hanskimvz/ELOP/doc/image/Create_a_beautiful_modern_and_visually_appealing-1786338362931.png

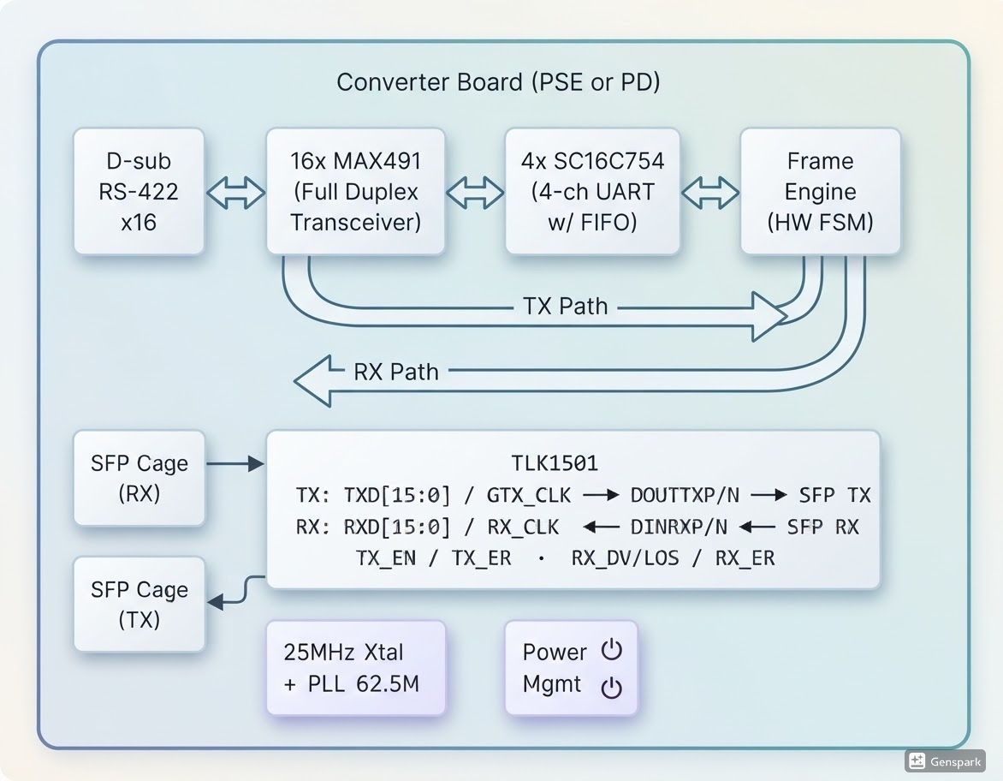
doc/image/Create_a_beautiful_modern_and_visually_appealing-1786338362931.png
