hanskimvz/ELOP/doc/RS422_-_광_컨버터_개발_제안_20260803103215.pptx

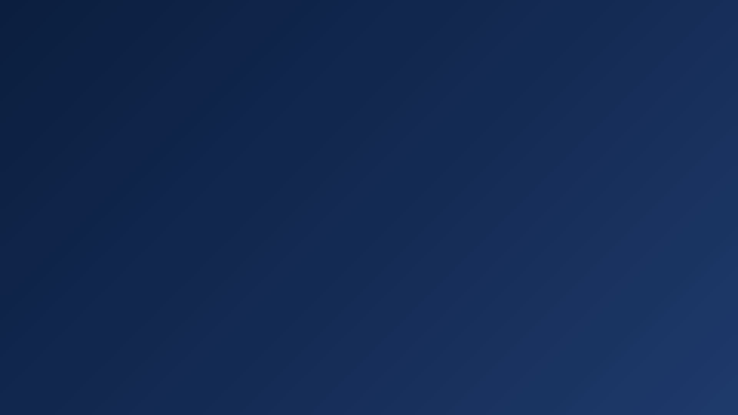
[picture p2: figure]

RS-422 ↔ Fiber

Optical Converter

Full Duplex Serializer / Deserializer for Multi-Channel RS-422 Communication

4채널 테스트 버전 사양 및 64채널 확장 로드맵 제안

2026.08.03 · REV 1.0 · CONFIDENTIAL

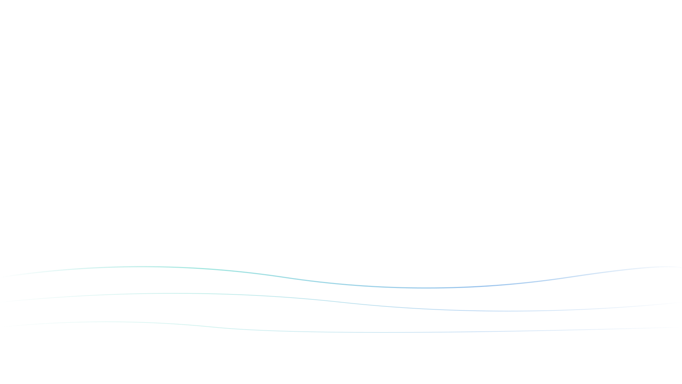
[picture p3: figure]

XBEAM TECH

FIBER · SIGNAL · SYSTEM

TECHNICAL PROPOSAL / ITEM #1-2

BAUD

1 ~ 8 Mbps

CHANNELS

4 → 64

FIBER LINK

1 Gbps SM

DUPLEX

Full

## Slide 2

01 / OVERVIEW

시스템 개요

XBEAM TECH

64채널 RS-422를 단일 광링크로

Full Duplex Serializer / Deserializer 시스템 개발 제안

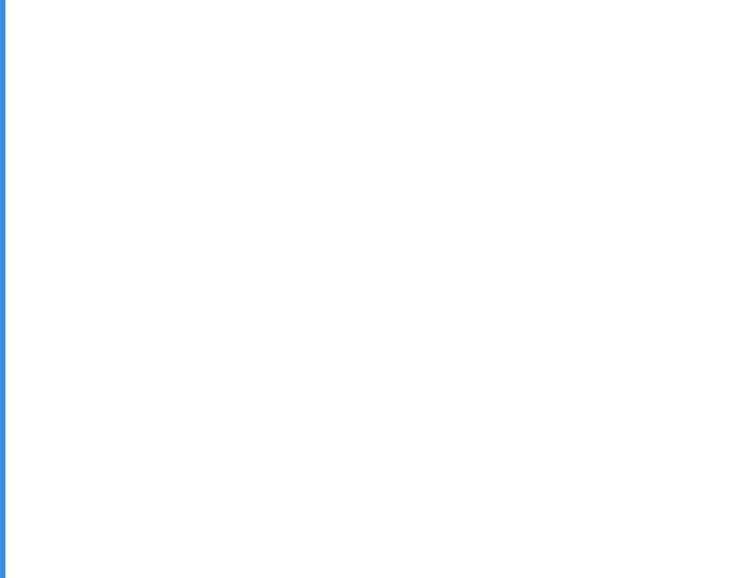
[picture p4: figure]

CONCEPT

다채널 RS-422 UART 데이터를 하나의 고속 광 링크로 전송/복원

송신부(PSE)와 수신부(PD) 한 쌍으로 구성되며,
Hybrid Cable(2 Fibers + 2 Copper) 하나로
다채널 시리얼 데이터와 전원을 동시 전달합니다.

KEY OBJECTIVES

© X-BEAM TECH · RS422 Optical Converter Proposal

3-ITEM COMPOSITION

본 제안은 아래 3개 아이템 개발 범위를 포함합니다

Converter (PSE)

송신 측 · Power Sourcing Equipment · D-sub → Hybrid

RS422 → FPGA(SerDes) → TOSA/ROSA · 외부 전원 또는 USB 전원 입력

01

TOSA/ROSA → FPGA(SerDes) → RS422 · Hybrid Cable로 전원 수신

01

다채널 UART 동시 처리

02

Full Duplex TX/RX 지원

02

Converter (PD)

수신 측 · Powered Device · Hybrid → D-sub

03

05

낮은 Latency 보장

FPGA 구현 단순화

04

06

Deterministic 전달 시간

채널별 독립 처리

Single Mode Fiber(G657B3) · 전송 거리 10 m 이내 · Hybrid Connector 양단

03

Hybrid Cable

2 Fibers (신호) + 2 Copper (전원) 일체형

02 / 10

## Slide 3

02 / SYSTEM ARCHITECTURE

개발 아이템 구성도

XBEAM TECH

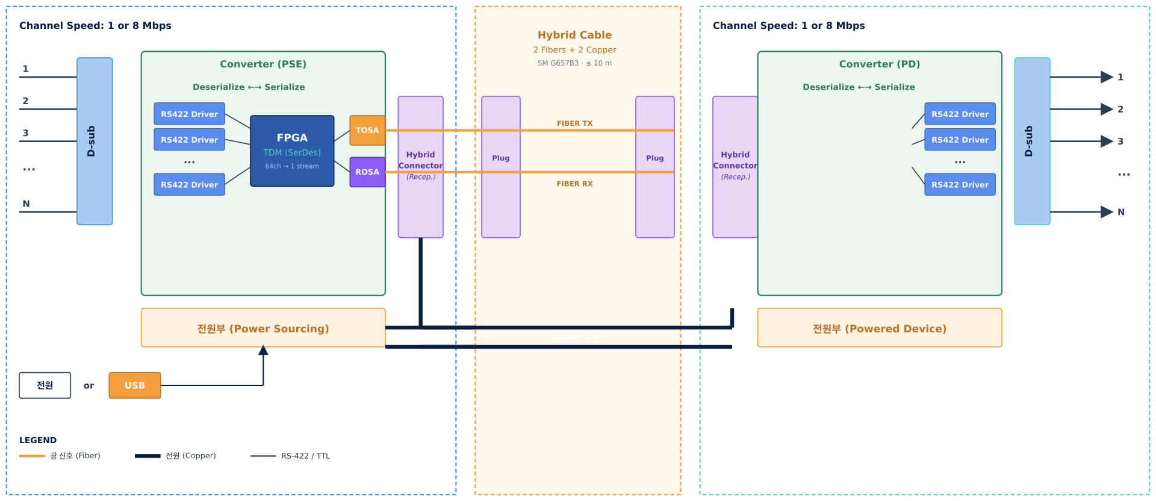
[picture p5: figure]

ITEM 01 · CONVERTER (PSE)

ITEM 03 · CABLE

ITEM 02 · CONVERTER (PD)

› CHANNEL SPEED · 1 or 8 Mbps

› FIBER · G657B3 SM

› DISTANCE · ≤ 10 m

› TEMP · −40 ~ 85 ℃

› POWER · via Copper

© X-BEAM TECH · RS422 Optical Converter Proposal

03 / 10

## Slide 4

03 / SPECIFICATION

개발 사양표 · Item #1-2

XBEAM TECH

Test Version (4채널) 개발 사양

RS422 ↔ 광 컨버터 · 4채널 검증용 시제품 규격

# | 항목 | 사양

01 | RS422 입력 속도 | 1 ~ 8 Mbps/ Channel
02 | RS422 최대 신호수 | 4 채널(Test 버전)
03 | 광 포트 | Hybrid Connector [TBD]
04 | 광섬유 | Single Mode G657B3
05 | 광 전송 거리 | ≤ 10 m
06 | 사이즈 | 가능한 작게 [TBD]
07 | 운용 온도 | −40 ~ 85 ℃

TEST SCOPE NOTE

기능 시험 시료 범위에서
일부 환경 사양 제외

본 시료는 기능 검증용이므로
아래 사양은 이번 단계에서 제외합니다.

✕ 진동 · 충격 등 환경 사양

✕ 전자기 적합성 (EMC)

EXTENSION TARGET

최종 64채널 확장 시
동일 프레임 구조 유지

본 4채널 시료는 최종 64채널 제품과
동일한 FPGA, 광 인터페이스, 프레임 프로토콜을 사용합니다.
→ 채널 수만 확장하면 재개발 없이 스케일업 가능

TEST BANDWIDTH

4 × 8 Mbps = 32 Mbps

→

FIBER LINK CAPACITY

1 Gbps (≈ 30배 여유)

© X-BEAM TECH · RS422 Optical Converter Proposal

04 / 10

## Slide 5

04 / DESIGN TRADE-OFF

Fiber Frame 구조 선택

XBEAM TECH

고정 Frame vs Packet(Hybrid) 방식 비교

1Mbps 사양에서는 고정 Frame 방식이 우수 · 8Mbps 확장 시 Hybrid 방식 검토 필요

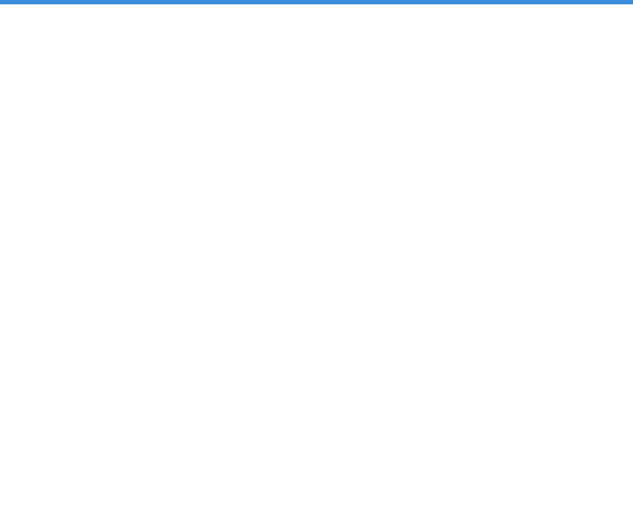
[picture p6: figure]

채널 위치 기반 고정 프레임
+ VALID MAP

✓ PROS

· Channel ID 불필요 — 위치가 곧 채널

· FPGA Parsing 로직 매우 단순

· 모든 채널이 동일 Latency 보장 (Deterministic)

· Round Robin Scheduler 불필요

✕ CONS

· 8Mbps × 64ch 조건에서 1B 슬롯 부족

· Idle 채널도 슬롯 소비 → 대역폭 낭비 가능

BEST FOR:1 Mbps/ch · Test 4채널 · 최종 64ch @ 1Mbps

© X-BEAM TECH · RS422 Optical Converter Proposal

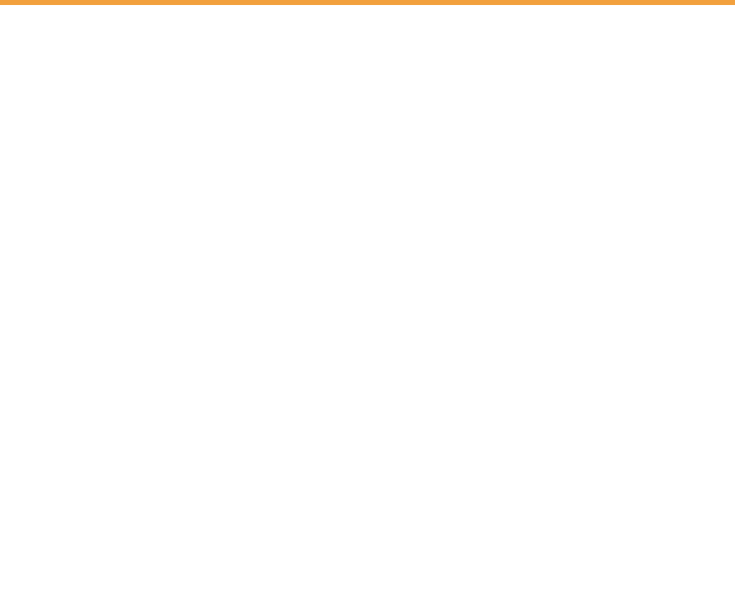
[picture p7: figure]

가변 슬롯 or 이벤트 기반
Packet 프레임

✓ PROS

· 채널별 Burst 전송에 유연 (8Mbps 대응 가능)

· Idle 채널 대역폭 낭비 없음

· Frame Rate 낮춰도 고속 채널 처리 가능

✕ CONS

· FPGA Parser / Scheduler 복잡

· 채널별 Latency 편차 발생 가능

· Channel ID 오버헤드 존재

BEST FOR:8 Mbps/ch × 64채널 확장 시나리오

OPTION A

FIXED FRAME

OPTION B

HYBRID / PACKET

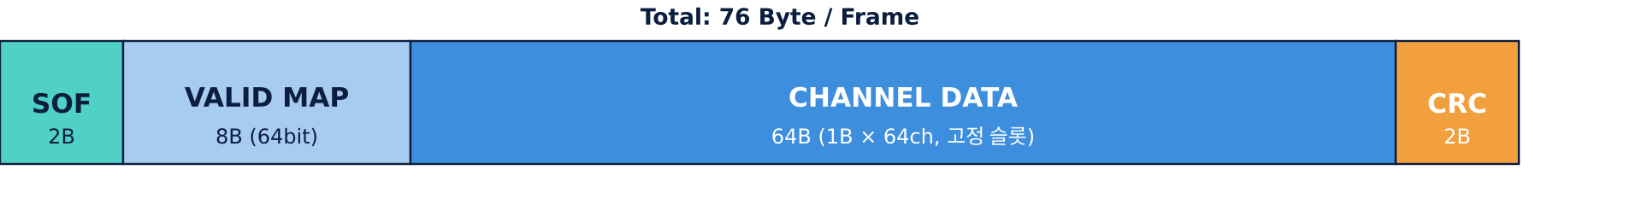
[picture p8: figure]
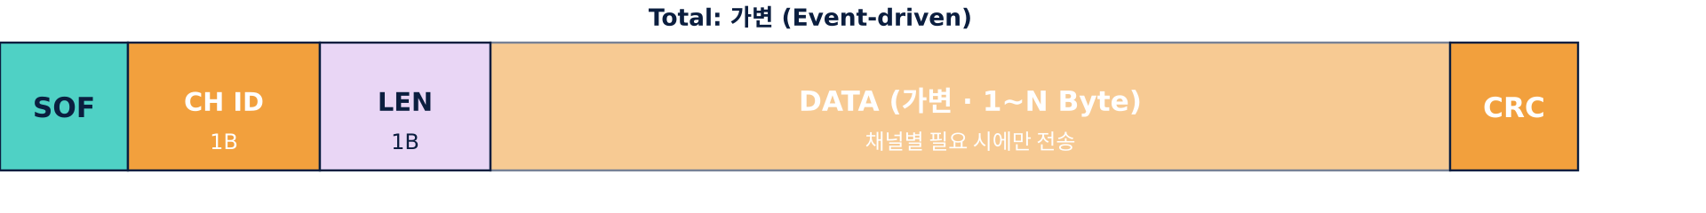
[picture p9: figure]

05 / 10

## Slide 6

05 / BANDWIDTH CALCULATION

대역폭 산정 근거

XBEAM TECH

1Gbps Fiber Link의 여유 검증

Test 4채널부터 최종 64채널 × 8Mbps 시나리오까지 · Full Duplex 기준

CORE FORMULA

Peak Bandwidth =
Channels × Baud/ch × Direction

· Full Duplex는 TX/RX가 물리적으로 독립 → 방향별 최대치만 확인
· UART Framing 오버헤드(Start/Stop bit) 및 Frame Header는 별도 여유율에 반영

시나리오 | CH | Baud/ch | 방향별 대역폭 | 1Gbps 대비
Test (기본) | 4 | 1 M | 4 Mbps | 0.4%
Test (최악) | 4 | 8 M | 32 Mbps | 3.2%
최종 (기본) | 64 | 1 M | 64 Mbps | 6.4%
최종 (최악) | 64 | 8 M | 512 Mbps | 51%

1Gbps FIBER LINK UTILIZATION (per direction)

CONCLUSION · 1Mbps 기준

64채널 × 1Mbps → 6.4% 사용 · 15배 여유
고정 Frame 방식으로 충분히 처리 가능

© X-BEAM TECH · RS422 Optical Converter Proposal

NOTE · 8Mbps 요구 시

64ch × 8Mbps → 51% 사용 · 여전히 여유 있음
단, 프레임은 Hybrid/Packet 방식 재설계 필요

06 / 10

## Slide 7

06 / FIFO & LATENCY

채널 버퍼 및 지연 시간 산정

XBEAM TECH

Baud rate에 따라 FIFO 깊이가 달라져야 합니다

1 Byte 전송 시간 기준으로 채널 버퍼 최소 크기 산정

BYTE TIME ANALYSIS

채널당 1 Byte 전송 시간

RECOMMENDATION

Baud rate 별
채널당 FIFO 크기

· 64ch × 32B × 2방향 = 4 KB
· 최신 FPGA 내부 BRAM 기준 매우 작은 양

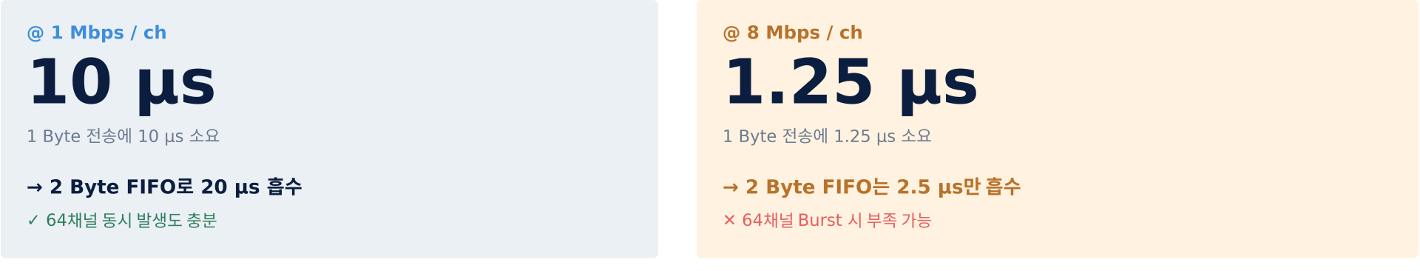
[picture p10: figure]

≤ 1 Mbps

2 ~ 4 Byte

~ 4 Mbps

8 Mbps (권장)

16 ~ 32 Byte

8 ~ 16 Byte

END-TO-END LATENCY PATH

Deterministic Frame 방식 · 채널별 균등 Latency

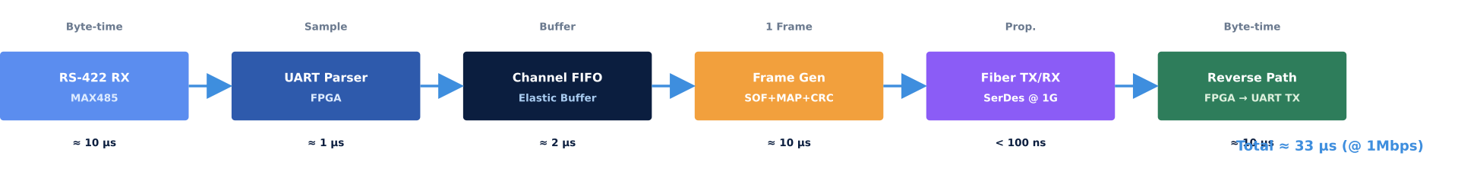
[picture p11: figure]

© X-BEAM TECH · RS422 Optical Converter Proposal

07 / 10

## Slide 8

07 / FPGA INTERNAL

FPGA 내부 구조 및 UART 구현

XBEAM TECH

TX / RX Path 대칭 구조 + 채널별 UART Engine

UART IP는 자체 구현 · Baud Tick + Shift Register + FSM · 채널당 자원 소모 매우 작음

TX / RX PATH

Fiber Serializer / Deserializer 데이터 경로

© X-BEAM TECH · RS422 Optical Converter Proposal

UART ENGINE

FPGA UART는
자체 구현 (Custom HDL)

Vendor IP (AXI UART 등)는 CPU 연결용이라
다채널 스트림 처리에는 오버스펙.

· Baud Tick 카운터 (per-ch parameter)

· 8-bit Shift Register + FSM

· 8× Oversampling (안정적 수신)

· 채널당 리소스 < 100 LUT

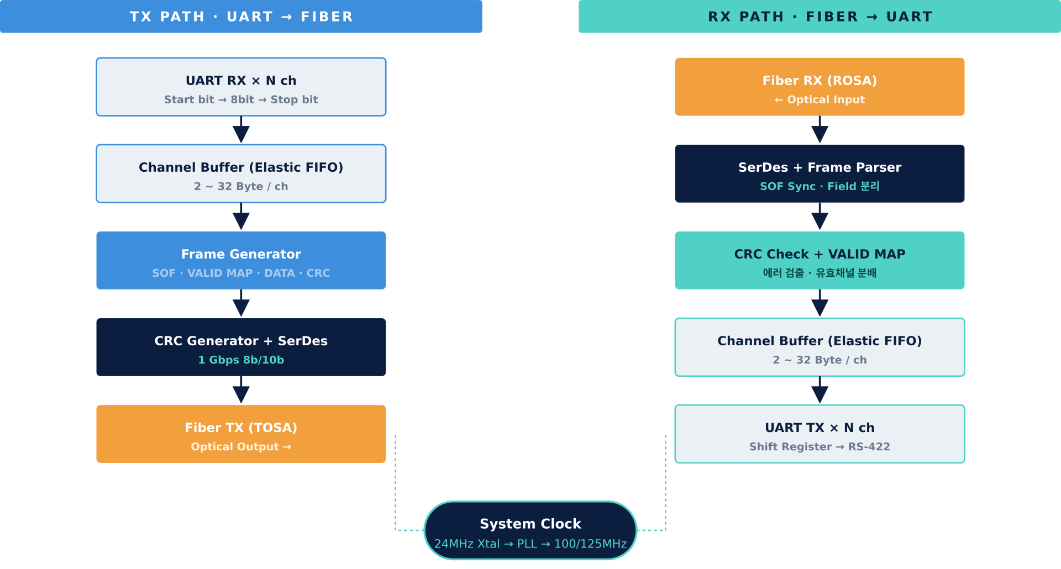
[picture p12: figure]

BAUD TICK EXAMPLE

· 100MHz / 1Mbps = 100 ticks/bit
· 100MHz / 8Mbps = 12.5 ticks/bit

→ 8Mbps 지원을 위해 시스템 클럭 100 ~ 125MHz 권장

RESOURCE ESTIMATE (64ch)

· UART Engine × 128 (RX+TX) ≈ 13K LUT
· Channel Buffer 4 KB ≈ 1~2 BRAM
· 최신 mid-range FPGA에서 여유 있게 수용

08 / 10

## Slide 9

08 / ROADMAP

4채널 → 64채널 확장 전략

XBEAM TECH

Test Board는 최종 제품의 축소판이 되어야 합니다

FPGA · 광 인터페이스 · Frame 프로토콜을 동일하게 유지 → 채널 수만 확장하면 재개발 최소화

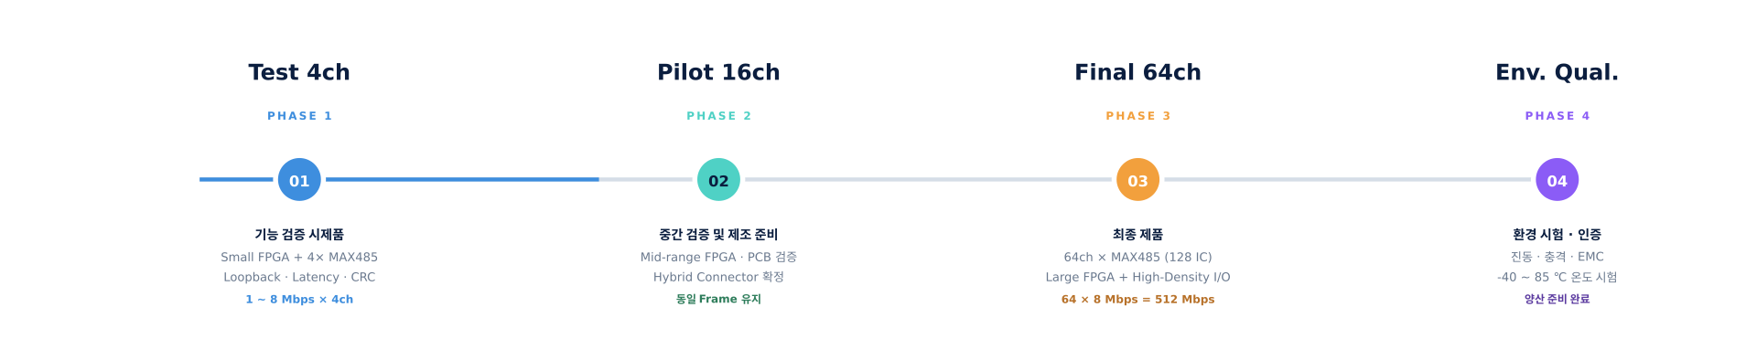
[picture p13: figure]

✓ 유지되는 것 (Phase 1 → 4)

복사 수준으로 확장 가능한
공통 요소

› Frame Protocol (SOF · VALID MAP · CRC)

› FPGA 계열 및 SerDes IP

› 광 인터페이스 (TOSA/ROSA · G657B3)

› UART Engine RTL (per-ch instance)

› 클럭 트리 (24MHz Xtal + PLL)

© X-BEAM TECH · RS422 Optical Converter Proposal

△ Phase마다 재검토

규모 확장에 따라
변경/확정이 필요한 요소

› FPGA Device 크기 / 패키지 (I/O 핀 수)

› Frame Slot 폭 (1B → 8B, 8Mbps 시)

› Channel FIFO 깊이 (2B → 32B)

› RS-422 Transceiver 개수 및 PCB 배선

› Hybrid Connector 사양 확정

09 / 10

## Slide 10

다채널 RS-422 → 광 링크

단순하고 확장 가능한 구조

NEXT STEPS

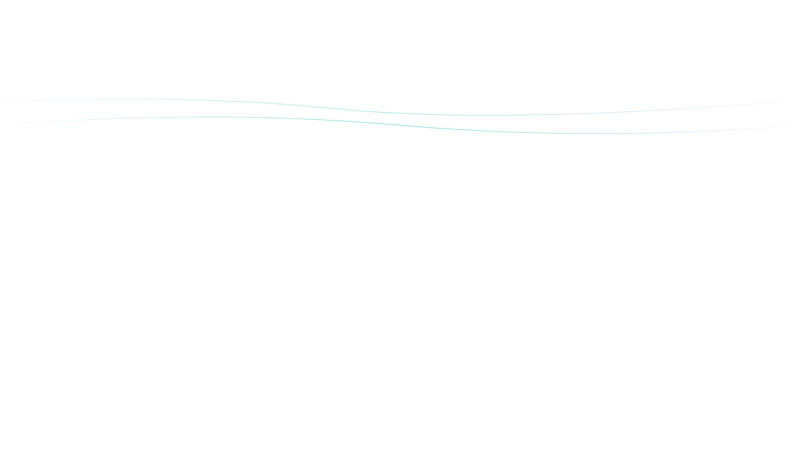
[picture p14: figure]

SUMMARY · 09 / 10

XBEAM TECH

01

고정 Frame + VALID MAP 방식

· Deterministic Latency
· FPGA Parser 매우 단순
· 1Mbps 사양에 최적

02

1 Gbps Fiber Link · 여유율 확보

· 최대 시나리오 · 51% 사용
· 4채널 시제품 · 3.2% 사용
· Full Duplex 완전 독립 채널

03

4채널 → 64채널 매끄러운 확장

· 동일 FPGA IP 재사용
· 동일 Frame Protocol
· PCB · I/O 스케일업만 진행

STEP 1

Hybrid Connector 사양 확정 · 광섬유 벤더 선정

STEP 2

Baud Rate 요구사항 최종 확정 (1M vs 8M) · Frame 방식 결정

STEP 3

4채널 Test Board 시제작 착수 · Loopback / CRC / Latency 검증

© 2026 · X-BEAM TECH · CONFIDENTIAL

Thank you · Q & A
