hanskimvz/ELOP/doc/RS422_-_광_컨버터_개발_제안_20260803101607.pdf

## X B E A M T E C H

F I B E R · S I G N A L · S Y S T E M

T E C H N I C A L | P R O P O S A L | / | I T E M | # 1 - 2

# RS-422 ↔ Fiber Optical Converter

# Full Duplex Serializer / Deserializer for Multi-Channel RS-422 Communication

## 4채널 테스트 버전 사양 및 64채널 확장 로드맵 제안

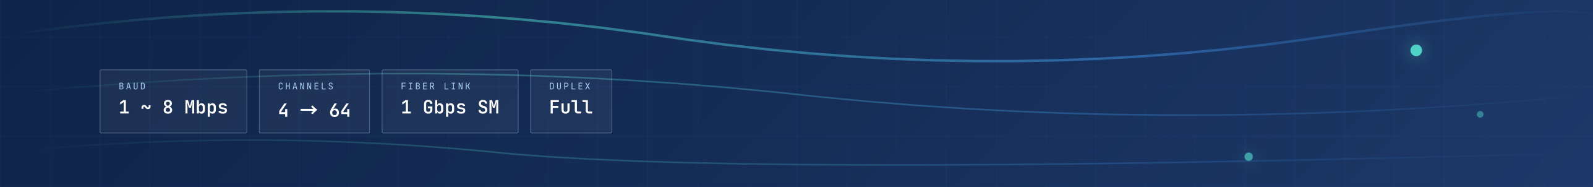
[picture p15: figure]
B A U D 1 ~ 8 Mbps; 1 Gbps SM; D U P L E X Full

2 0 2 6 . 0 8 . 0 3 | · | R E V | 1 . 0 | · | C O N F I D E N T I A L

0 1 | / | O V E R V I E W

# 시스템 개요

X B E A M T E C H

# 64채널 RS-422를 단일 광링크로

# Full Duplex Serializer / Deserializer 시스템 개발 제안

C O N C E P T

# 다채널 RS-422 UART 데이터를 하나의 고속 광 링크로 전 송/복원

송신부(PSE)와 수신부(PD) 한 쌍으로 구성되며,

### Hybrid Cable(2 Fibers + 2 Copper) 하나로

다채널 시리얼 데이터와 전원을 동시 전달합니다.

K E Y | O B J E C T I V E S
01 다채널 UART 동시 처리 | 02 Full Duplex TX/RX 지원
03 낮은 Latency 보장 | 04 Deterministic 전달 시간
05 FPGA 구현 단순화 | 06 채널별 독립 처리
3 - I T E M | C O M P O S I T I O N

## 본 제안은 아래 3개 아이템 개발 범위를 포함합니다

# 01 Converter (PSE)

송신 측 · Power Sourcing Equipment · D-sub → Hybrid RS422 → FPGA(SerDes) → TOSA/ROSA · 외부 전원 또는 USB 전원 입력

# 02 Converter (PD)

수신 측 · Powered Device · Hybrid → D-sub TOSA/ROSA → FPGA(SerDes) → RS422 · Hybrid Cable로 전원 수신

# 03 Hybrid Cable

### 2 Fibers (신호) + 2 Copper (전원) 일체형

Single Mode Fiber(G657B3) · 전송 거리 10 m 이내 · Hybrid Connector 양단

© X-BEAM TECH · RS422 Optical Converter Proposal | 02 / 10

# 개발 아이템 구성도

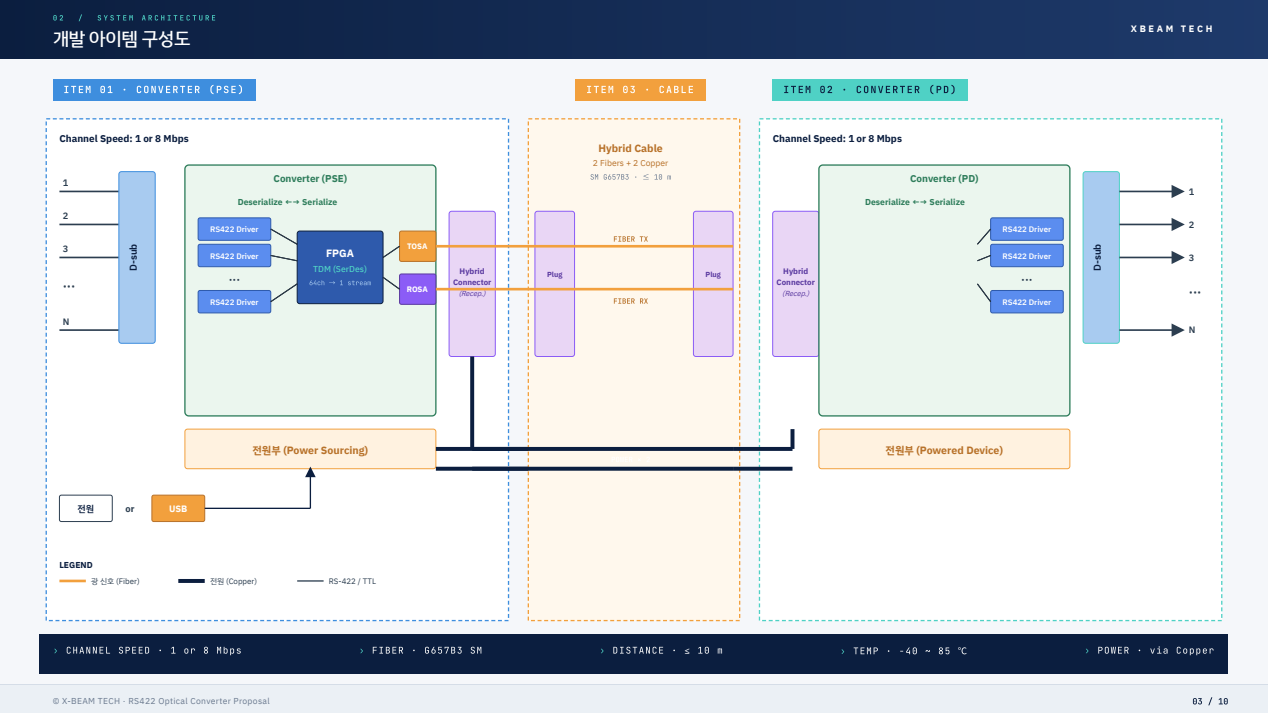
[picture p16: page 3]
Converter (PSE); Deserialize ←→ Serialize; RS422 Driver; RS422 Driver ···; FPGA TDM (SerDes); 64ch → 1 stream; TOSA; ROSA; USB; Hybrid Connector (Recep.); Plug; FIBER TX; FIBER RX; POWER × 2; Hybrid Cable 2 Fibers + 2 Copper; 1 stream → 64ch; Converter (PD); LEGEND; 광 신호 (Fiber); 전원 (Copper); RS-422 / TTL; ITEM 01 · CONVERTER (PSE); ITEM 03 · CABLE; ITEM 02 · CONVERTER (PD); › CHANNEL SPEED · 1 or 8 Mbps; › FIBER · G657B3 SM; › DISTANCE · ≤ 10 m; › TEMP · −40 ~ 85 ℃; › POWER · via Copper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

Channel Speed: 1 or 8 Mbps

전원부 (Power Sourcing)

전원부 (Powered Device)

# | 항목 | 사양

01 | RS422 입력 속도 | 1 ~ 8 Mbps / Channel
02 | RS422 최대 신호수 | 4 채널 (Test 버전)
03 | 광 포트 | Hybrid Connector [TBD]
04 | 광섬유 | Single Mode G657B3
05 | 광 전송 거리 | ≤ 10 m
06 | 사이즈 | 가능한 작게 [TBD]
07 | 운용 온도 | −40 ~ 85 ℃
0 3 | / | S P E C I F I C A T I O N

# 개발 사양표 · Item #1-2

# Test Version (4채널) 개발 사양

## RS422 ↔ 광 컨버터 · 4채널 검증용 시제품 규격

T E S T | S C O P E | N O T E

# 기능 시험 시료 범위에서 일부 환경 사양 제외

본 시료는 기능 검증용이므로
아래 사양은 이번 단계에서 제외합니다.

✕ 진동 · 충격 등 환경 사양
✕ 전자기 적합성 (EMC)

E X T E N S I O N T A R G E T

# 최종 64채널 확장 시 동일 프레임 구조 유지

본 4채널 시료는 최종 64채널 제품과
동일한 FPGA, 광 인터페이스, 프레임 프로토콜을 사용합니다. → 채널 수만 확장하면 재개발 없이 스케일업 가능
T E S T | B A N D W I D T H
4 × 8 Mbps = 32 Mbps | →
F I B E R | L I N K | C A P A C I T Y
1 Gbps (≈ 30배 여유)
© X-BEAM TECH · RS422 Optical Converter Proposal | 04 / 10

0 4 | / | D E S I G N | T R A D E - O F F

# Fiber Frame 구조 선택

# 고정 Frame vs Packet(Hybrid) 방식 비교

1Mbps 사양에서는 고정 Frame 방식이 우수 · 8Mbps 확장 시 Hybrid 방식 검토 필요

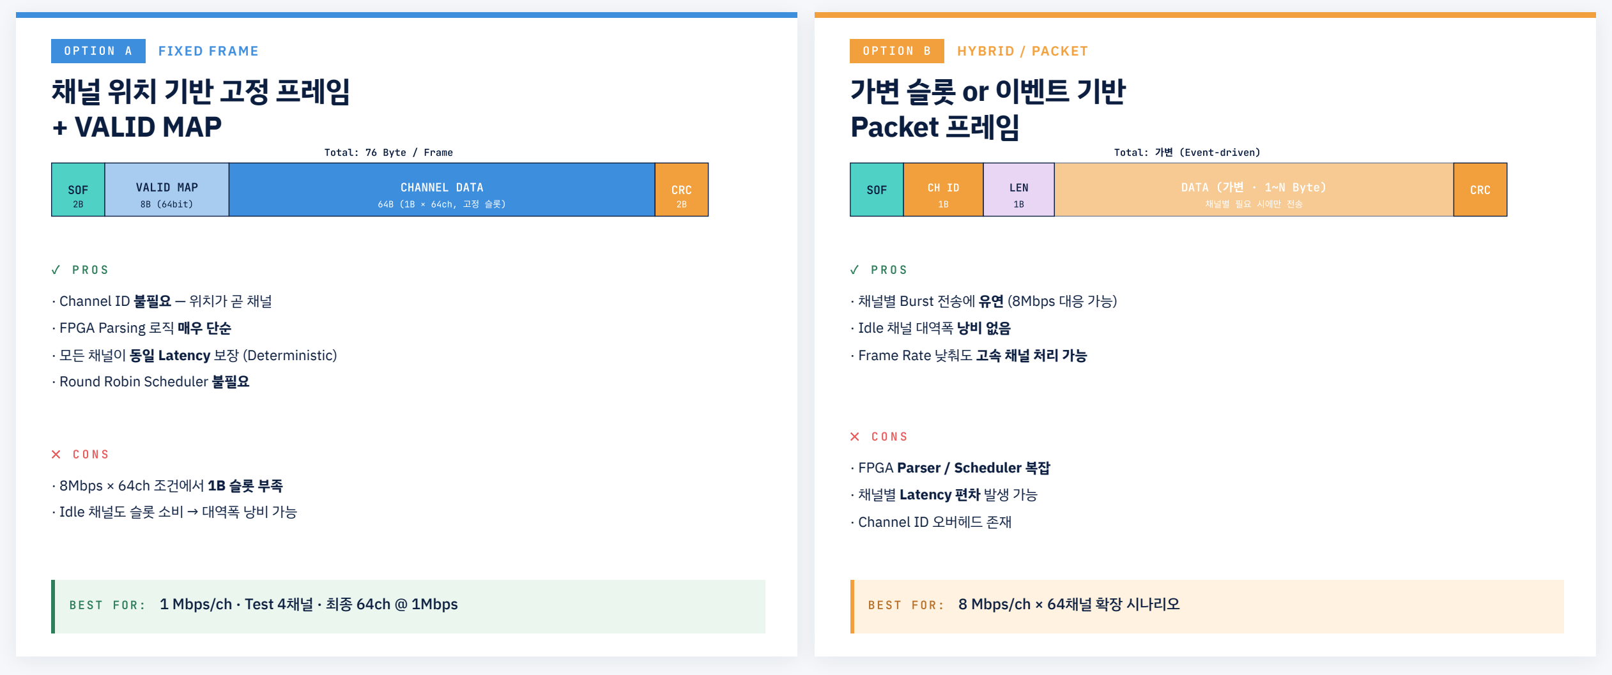
[picture p17: figure]
SOF; VALID MAP; 8B (64bit); CHANNEL DATA; CRC; Total: 76 Byte / Frame; LEN; DATA (가변 · 1~N Byte); 채널별 필요 시에만 전송; Total: 가변 (Event-driven); FIXED FRAME; 채널 위치 기반 고정 프레임 + VALID MAP; ✓ P R O S · Channel ID 불필요 — 위치가 곧 채널 · FPGA Parsing 로직 매우 단순 · 모든 채널이 동일 Latency 보장 (Deterministic) · Round Robin Scheduler 불필요; ✕ C O N S · 8Mbps × 64ch 조건에서 1B 슬롯 부족 · Idle 채널도 슬롯 소비 → 대역폭 낭비 가능; HYBRID / PACKET; 가변 슬롯 or 이벤트 기반 Packet 프레임; ✓ P R O S · 채널별 Burst 전송에 유연 (8Mbps 대응 가능) · Idle 채널 대역폭 낭비 없음 · Frame Rate 낮춰도 고속 채널 처리 가능; ✕ C O N S · FPGA Parser / Scheduler 복잡 · 채널별 Latency 편차 발생 가능 · Channel ID 오버헤드 존재

B E S T | F O R : | 1 Mbps/ch · Test 4채널 · 최종 64ch @ 1Mbps
B E S T | F O R : | 8 Mbps/ch × 64채널 확장 시나리오
© X-BEAM TECH · RS422 Optical Converter Proposal | 05 / 10

시나리오 | CH | Baud/ch | 방향별 대역폭 | 1Gbps 대비
Test (기본) | 4 | 1 M | 4 Mbps | 0.4%
Test (최악) | 4 | 8 M | 32 Mbps | 3.2%
최종 (기본) | 64 | 1 M | 64 Mbps | 6.4%
최종 (최악) | 64 | 8 M | 512 Mbps | 51%
Test 4ch × 8Mbps → 32 Mbps | 3.2%
최종 64ch × 1Mbps → 64 Mbps | 6.4%
최종 64ch × 8Mbps → 512 Mbps | 51%

1 Gbps (100%)

0 5 | / | B A N D W I D T H | C A L C U L A T I O N

# 대역폭 산정 근거

# 1Gbps Fiber Link의 여유 검증

Test 4채널부터 최종 64채널 × 8Mbps 시나리오까지 · Full Duplex 기준

C O R E F O R M U L A

# Peak Bandwidth =

Channels | × | Baud/ch | × | Direction
- Full Duplex는 TX/RX가 물리적으로 독립 → 방향별 최대치만 확인
- UART Framing 오버헤드(Start/Stop bit) 및 Frame Header는 별도 여유율에 반영
1 G b p s | F I B E R | L I N K | U T I L I Z A T I O N | ( p e r | d i r e c t i o n )
C O N C L U S I O N | · | 1 M b p s | 기 준

## 64채널 × 1Mbps → 6.4% 사용 · 15배 여유

고정 Frame 방식으로 충분히 처리 가능

N O T E | · | 8 M b p s | 요 구 시

## 64ch × 8Mbps → 51% 사용 · 여전히 여유 있음

단, 프레임은 Hybrid/Packet 방식 재설계 필요

© X-BEAM TECH · RS422 Optical Converter Proposal | 06 / 10

# 채널 버퍼 및 지연 시간 산정

# Baud rate에 따라 FIFO 깊이가 달라져야 합니다

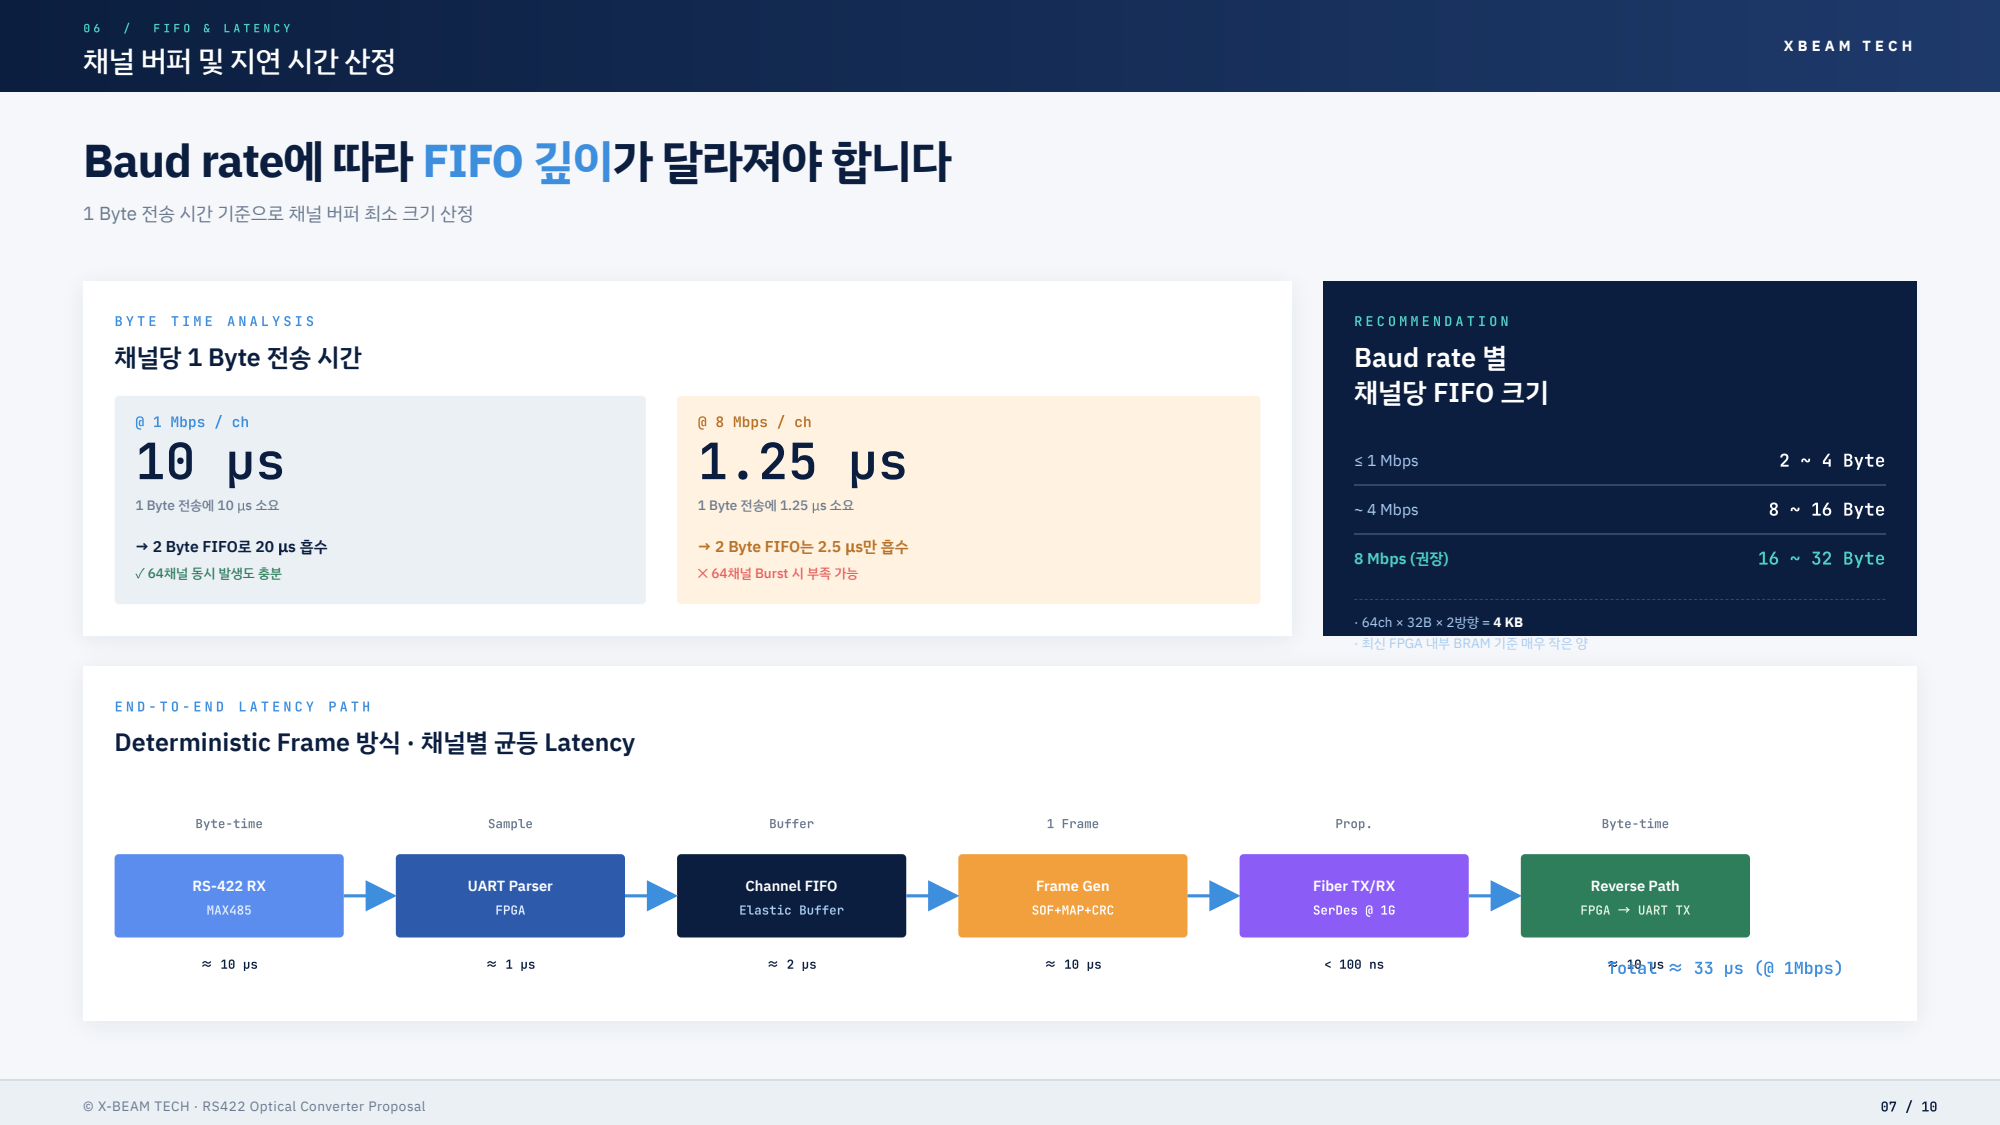
[picture p18: page 7]
@ 1 Mbps / ch 10 μs; @ 8 Mbps / ch 1.25 μs; MAX485; UART Parser; FPGA; Channel FIFO; Elastic Buffer; Frame Gen; SerDes @ 1G; Reverse Path; Byte-time; Sample; Buffer; 1 Frame; Prop.; ≈ 10 μs Total ≈ 33 μs (@ 1Mbps); ≤ 1 Mbps; 2 ~ 4 Byte; ~ 4 Mbps; 8 ~ 16 Byte; 8 Mbps (권장); 16 ~ 32 Byte; © X-BEAM TECH · RS422 Optical Converter Proposal

1 Byte 전송 시간 기준으로 채널 버퍼 최소 크기 산정

채널당 1 Byte 전송 시간

Baud rate 별
채널당 FIFO 크기

1 Byte 전송에 10 μs 소요
→ 2 Byte FIFO로 20 μs 흡수
✓ 64채널 동시 발생도 충분

1 Byte 전송에 1.25 μs 소요
→ 2 Byte FIFO는 2.5 μs만 흡수
✕ 64채널 Burst 시 부족 가능

· 최신 FPGA 내부 BRAM 기준 매우 작은 양

Deterministic Frame 방식 · 채널별 균등 Latency

Fiber TX/RX

SOF+MAP+CRC

FPGA → UART TX

# FPGA 내부 구조 및 UART 구현

# TX / RX Path 대칭 구조 + 채널별 UART Engine

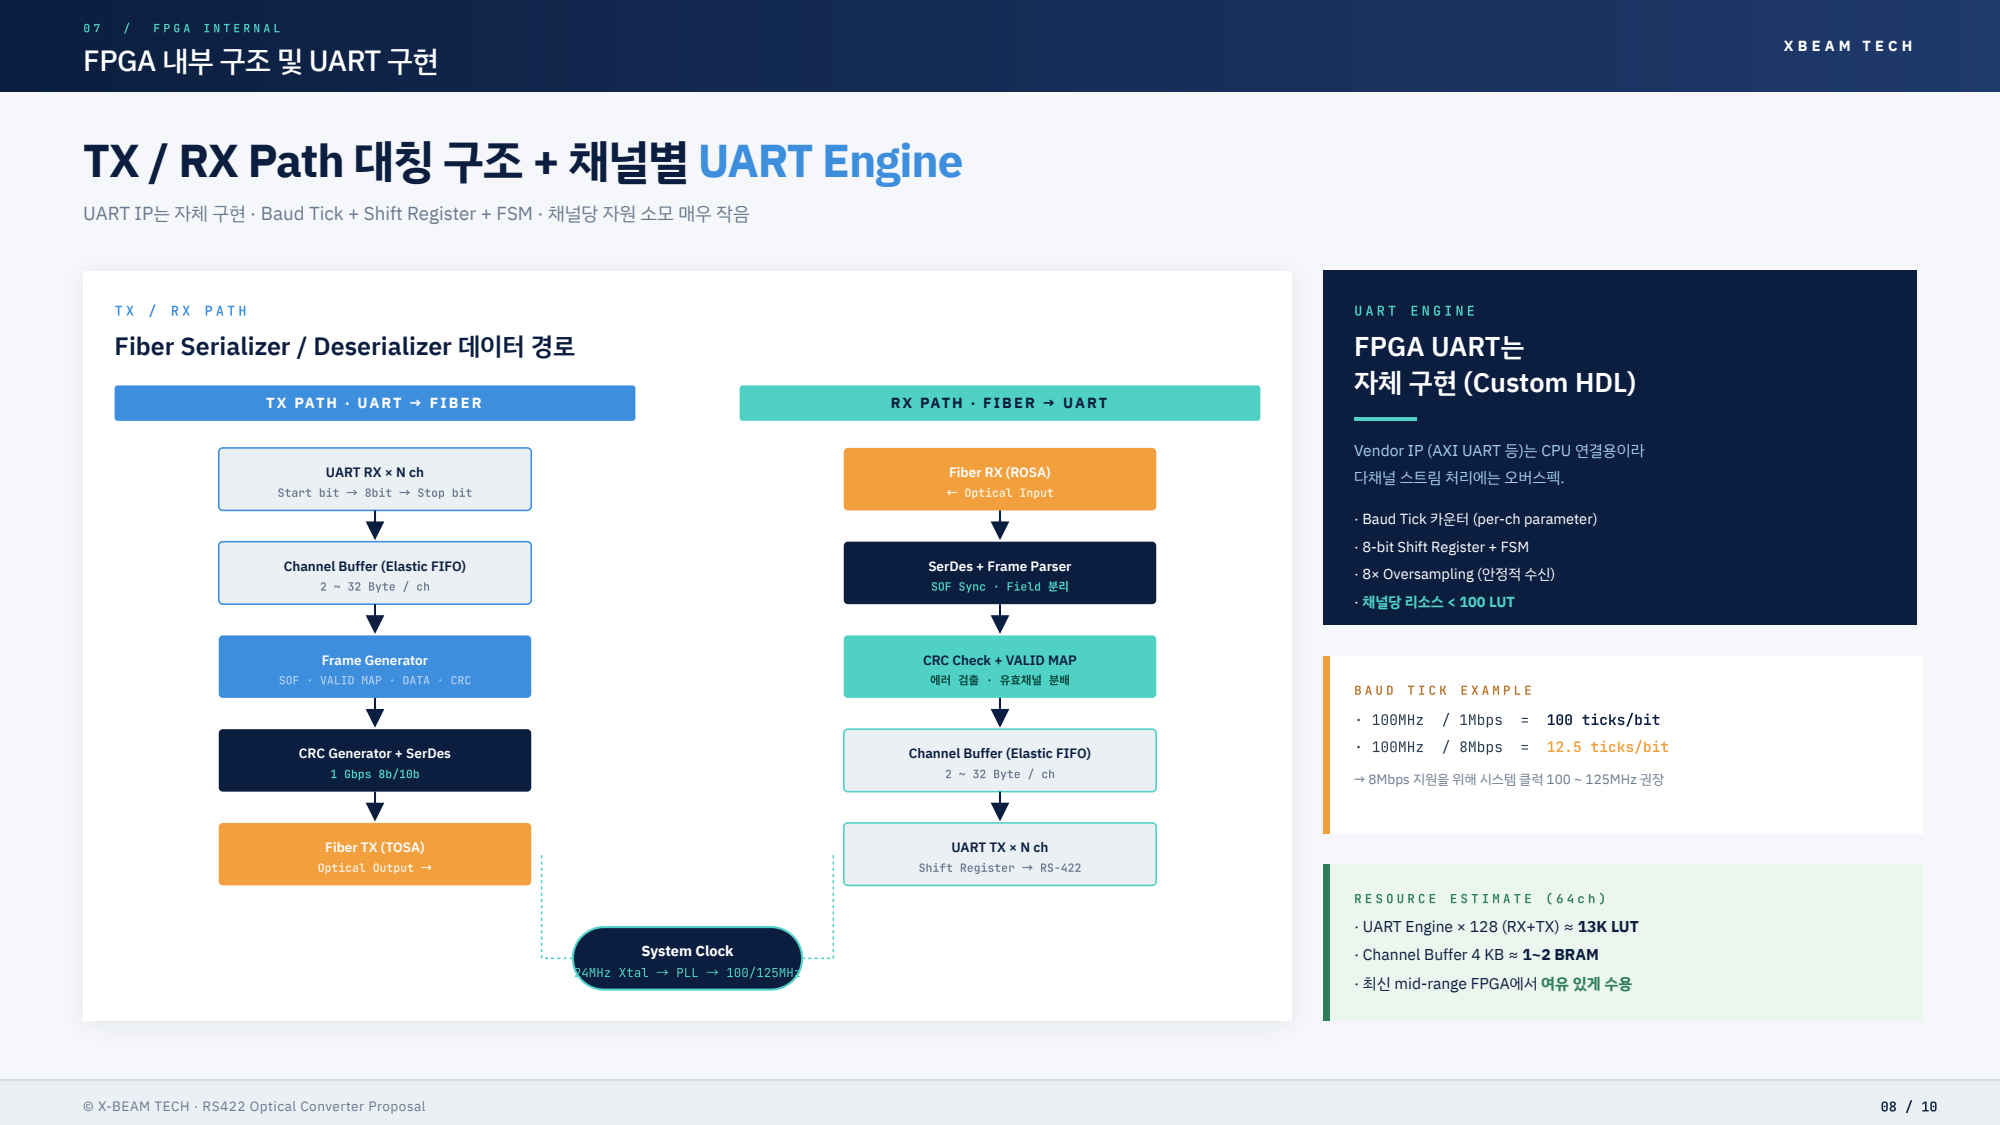
[picture p19: page 8]
2 ~ 32 Byte / ch; Frame Generator; 1 Gbps 8b/10b; Optical Output →; ← Optical Input; System Clock; 24MHz Xtal → PLL → 100/125MHz; · 100MHz; / 1Mbps; 100 ticks/bit; / 8Mbps; 12.5 ticks/bit; © X-BEAM TECH · RS422 Optical Converter Proposal

UART IP는 자체 구현 · Baud Tick + Shift Register + FSM · 채널당 자원 소모 매우 작음

Fiber Serializer / Deserializer 데이터 경로

FPGA UART는
자체 구현 (Custom HDL)

TX PATH · UART → FIBER

RX PATH · FIBER → UART

Vendor IP (AXI UART 등)는 CPU 연결용이라
다채널 스트림 처리에는 오버스펙.
· Baud Tick 카운터 (per-ch parameter)
· 8-bit Shift Register + FSM
· 8× Oversampling (안정적 수신)
· 채널당 리소스 < 100 LUT

UART RX × N ch

Fiber RX (ROSA)

Start bit → 8bit → Stop bit

Channel Buffer (Elastic FIFO)

SerDes + Frame Parser

SOF Sync · Field 분리

CRC Check + VALID MAP

SOF · VALID MAP · DATA · CRC

에러 검출 · 유효채널 분배

CRC Generator + SerDes

→ 8Mbps 지원을 위해 시스템 클럭 100 ~ 125MHz 권장

Fiber TX (TOSA)

UART TX × N ch

Shift Register → RS-422

· UART Engine × 128 (RX+TX) ≈ 13K LUT
· Channel Buffer 4 KB ≈ 1~2 BRAM
· 최신 mid-range FPGA에서 여유 있게 수용

# 4채널 → 64채널 확장 전략

# Test Board는 최종 제품의 축소판이 되어야 합니다

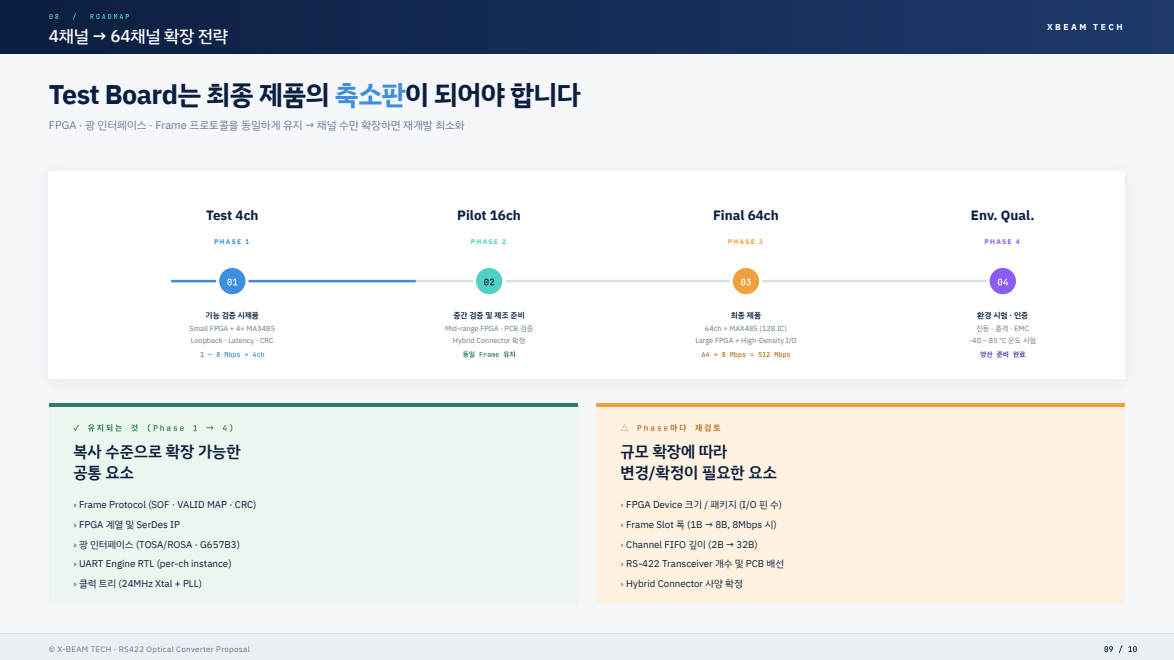
[picture p20: page 9]
Test 4ch; 1 ~ 8 Mbps × 4ch; Pilot 16ch; Final 64ch; 64 × 8 Mbps = 512 Mbps; Env. Qual.; © X-BEAM TECH · RS422 Optical Converter Proposal

FPGA · 광 인터페이스 · Frame 프로토콜을 동일하게 유지 → 채널 수만 확장하면 재개발 최소화

기능 검증 시제품
Small FPGA + 4× MAX485
Loopback · Latency · CRC

Mid-range FPGA · PCB 검증
Hybrid Connector 확정

64ch × MAX485 (128 IC)
Large FPGA + High-Density I/O

진동 · 충격 · EMC

동일 Frame 유지

복사 수준으로 확장 가능한

규모 확장에 따라
변경/확정이 필요한 요소

› Frame Protocol (SOF · VALID MAP · CRC)
› FPGA 계열 및 SerDes IP
› 광 인터페이스 (TOSA/ROSA · G657B3)
› UART Engine RTL (per-ch instance)
› 클럭 트리 (24MHz Xtal + PLL)

› FPGA Device 크기 / 패키지 (I/O 핀 수)
› Frame Slot 폭 (1B → 8B, 8Mbps 시)
› Channel FIFO 깊이 (2B → 32B)
› RS-422 Transceiver 개수 및 PCB 배선
› Hybrid Connector 사양 확정

S U M M A R Y | · | 0 9 | / | 1 0 | X B E A M T E C H

# 다채널 RS-422 → 광 링크 단순하고 확장 가능한 구조

01

# 고정 Frame + VALID MAP 방식

- Deterministic Latency
- FPGA Parser 매우 단순
- 1Mbps 사양에 최적

02

# 1 Gbps Fiber Link · 여유율 확보

- 최대 시나리오 · 51% 사용
- 4채널 시제품 · 3.2% 사용
- Full Duplex 완전 독립 채널

03

# 4채널 → 64채널 매끄러운 확장

- 동일 FPGA IP 재사용
- 동일 Frame Protocol
- PCB · I/O 스케일업만 진행
N E X T | S T E P S
S T E P | 1
Hybrid Connector 사양 확정 · 광섬유 벤더 선정

S T E P 2
Baud Rate 요구사항 최종 확정 (1M vs 8M) · Frame 방식 결정

S T E P 3
4채널 Test Board 시제작 착수 · Loopback / CRC / Latency 검증
T h a n k | y o u | · | Q & | A | © | 2 0 2 6 | · | X - B E A M | T E C H | · | C O N F I D E N T I A L
