hanskimvz/ELOP/schematic/Project Outputs for ELOP_V0.90/ELOP_V0.90.xls

Comment | Description | Designator | Footprint | LibRef | Quantity
4.7uF |  | BC1, BC7, BC27 | CS-1608 | 4.7uF | 3.0
0.1uF |  | BC2, BC3, BC4, BC5, BC6, BC8, BC11, BC12, BC13, BC14, BC15, BC16, BC17, BC18, BC19, BC20, BC21, BC22, BC23, BC24, BC25, BC26, BC28, BC29, BC30, BC31, BC32, BC33, BC34, BC35, BC36, BC37, BC38, BC44, BC51, BC57, C8, C11, C12, C26, C27, C28, C29 | CS-1005 | 0.1uF | 43.0
10nF |  | BC10, BC45, BC52, C1, C2, C3, C4, C5, C6 | CS-1005 | 10nF | 9.0
4.7uF/100V |  | BC39, BC42 | CS-3216 | 4.7uF/100V | 2.0
10uF |  | BC43, BC50 | CS-2012 | 10uF | 2.0
22uF |  | BC46, BC47, BC48, BC49, BC53, BC54, BC55, BC56 | CS-3216 | 22uF | 8.0
1uF |  | BC58 | CS-1005 | 1uF | 1.0
22uF |  | C7 | CTS-3216 | 22uF | 1.0
33pF |  | C9 | CS-1005 | 33pF | 1.0
3.3nF |  | C10 | CS-1005 | 3.3nF | 1.0
10pF |  | C13 | CS-1005 | 10pF | 1.0
0.1uF |  | C15 | CS-1608 | 0.1uF | 1.0
0.1uF//100V |  | C17, C18, C19, C22 | CS-2012 | 0.1uF//100V | 4.0
47pF |  | C20, C23 | CS-1005 | 47pF | 2.0
4.7nF |  | C21, C24 | CS-1005 | 4.7nF | 2.0
1.5nF |  | C25 | CS-1005 | 1.5nF | 1.0
15pF |  | C30 | CS-1005 | 15pF | 1.0
TH_HC-SFP-01L |  | CN1 | TH_HC-SFP-01L | TH_HC-SFP-01L | 1.0
RB051L-40 |  | D1 | SOD-106 | RB051L-40 | 1.0
MB6S |  | D2 | MB2S | MB6S | 1.0
600 |  | FB1, FB2, FB3, FB4, FB5, FB6, FB7, FB8, FB9, FB10 | LS-1608 | 600 | 10.0
Header_2.54_2p |  | J1 | Header_2.54_2p | Header_2.54_2p | 1.0
KF2EDGR-3.81-3P |  | J2 | KF2EDGV-3.81-3P | KF2EDGR-3.81-3P | 1.0
CON 2P |  | J3, J4 | KF2EDGV-3.81-2P | CON 2P | 2.0
KSP20LG154 |  | J5 | KSP20LG154 | KSP20LG154 | 1.0
KF2EDGRH-2.5-4pX2 |  | J6, J7, J8, J9 | KF2EDGRH-2.5-4PX2 | KF2EDGRH-2.5-4pX2 | 4.0
CDRH4D28-100 |  | L2 | CDRH4D28NP | CDRH4D28-100 | 1.0
CDRH4D28NP-7R4NC |  | L3, L4 | CDRH4D28NP | CDRH4D28NP-7R4NC | 2.0
LED |  | LD1, LD2, LD3, LD4, LD5 | LED1608 | LED | 5.0
4.04pi |  | MH4, MH5, MH6, MH8, MH11 | VA-2.2 | 4.04pi | 5.0
MIC9750 |  | MIC1 | MIC9767 | MIC9750 | 1.0
SiT8008BI-82-25E-62.500000 |  | OSC1 | SX7050 | SiT8008BI-82-25E-62.500000 | 1.0
25Mhz-SX32-3.3V |  | OSC2 | SX-32 | 25Mhz-SX32-3.3V | 1.0
MMBT6427/SOT-23 |  | Q1, Q2, Q3, Q4 | SOT-23 | MMBT6427/SOT-23 | 4.0
1K |  | R1, R35, R59, R75, R92, R94, R96 | RS-1005 | 1K | 7.0
10K//NC |  | R2 | RS-1005 | 10K//NC | 1.0
825 |  | R3 | RS-1005 | 825 | 1.0
49.9 |  | R4, R6, R7, R9, R10 | RS-1005 | 49.9 | 5.0
200 |  | R5 | RS-1005 | 200 | 1.0
100 |  | R8 | RS-1005 | 100 | 1.0
10K |  | R11, R12, R13, R14, R15, R16, R17, R18, R23, R25, R26, R27, R28, R29, R30, R31, R33, R64, R65, R66, R67, R68, R69, R70, R71, R72, R73, R74, R84, R85, R86, R87, R88, R89, R90 | RS-1005 | 10K | 35.0
4.7K |  | R19, R45, R49, R52, R55, R91, R93, R95 | RS-1005 | 4.7K | 8.0
2K |  | R20, R37 | RS-1005 | 2K | 2.0
500 |  | R21 | RS-1005 | 500 | 1.0
10 |  | R22, R34 | RS-1005 | 10 | 2.0
110 |  | R24, R32 | RS-1005 | 110 | 2.0
0 |  | R36 | RS-1005 | 0 | 1.0
47 |  | R39 | RS-1608 | 47 | 1.0
0.47 |  | R41 | RS-1608 | 0.47 | 1.0
30K |  | R42, R48 | RS-1005 | 30K | 2.0
32.4K_F |  | R43, R50 | RS-1005 | 32.4K_F | 2.0
16.9K |  | R44, R51 | RS-1005 | 16.9K | 2.0
243K |  | R46, R53 | RS-1005 | 243K | 2.0
10.2K_F |  | R47 | RS-1005 | 10.2K_F | 1.0
15K_F |  | R54 | RS-1005 | 15K_F | 1.0
475K |  | R56, R57 | RS-1005 | 475K | 2.0
16.7K |  | R58 | RS-1005 | 16.7K | 1.0
31.2K |  | R60 | RS-1005 | 31.2K | 1.0
17,8K |  | R61 | RS-1005 | 17,8K | 1.0
19.1K |  | R62 | RS-1005 | 19.1K | 1.0
47K |  | R63 | RS-1005 | 47K | 1.0
120 |  | R76, R77, R78, R79, R80, R81, R82, R83 | RS-1608 | 120 | 8.0
33 |  | R97 | RS-1005 | 33 | 1.0
SW DIP-8 |  | S1 | DIP_SW_8C | SW DIP-8 | 1.0
TLK1501RCP |  | U1 | PQFP-G64 | TLK1501RCP | 1.0
MAX3490CSA |  | U2, U3, U4, U5, U6, U7, U8, U9 | SOIC-8 | MAX3490CSA | 8.0
OPA340NA |  | U10, U13 | SOT23-5 | OPA340NA | 2.0
AD08060 |  | U11 | TSSOP-24 | AD08060 | 1.0
TLC7524 |  | U12 | SOP-16 | TLC7524 | 1.0
TPS54560 |  | U14, U15 | SOIC-8E | TPS54560 | 2.0
TPS25940L |  | U16 | WQFN20-4x3 | TPS25940L | 1.0
PMEG6045ETP |  | ZD1, ZD2 | SOD-128 | PMEG6045ETP | 2.0
