hanskimvz/ELOP/schematic/ELOP_V0.90.step

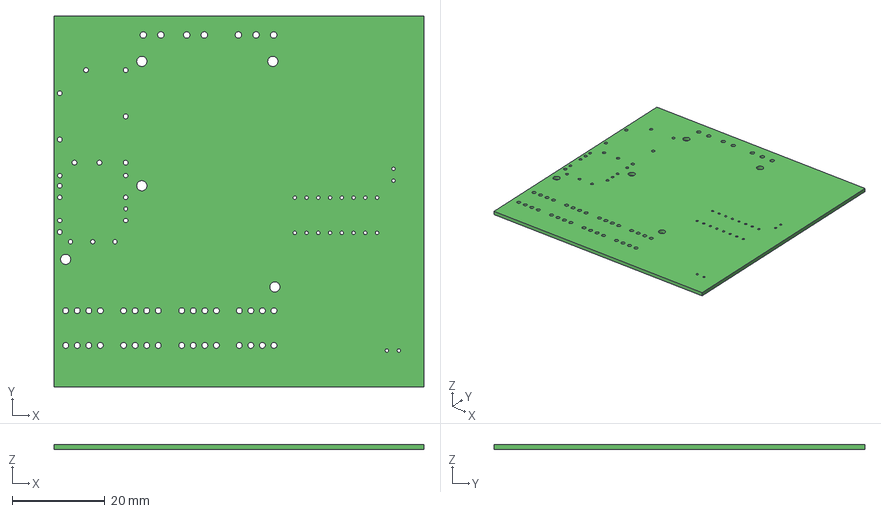
[picture p21: CAD file, 2026-10-06]
schematic/ELOP_V0.90.step
80.0 x 80.1 x 1.13 mm
