hanskimvz/ELOP/TestProgram/results/latency_B_ch1_20261005_140714.csv

# program_version: 0.1.0
# started: 2026-10-05T14:07:14
# pc: HPC
# port: COM4
# adapter: CH340 (USB-SERIAL CH340(COM4))
# setup: B - 로컬 RS-422 루프백 (로컬 MAX3490)
# channel_no: 1
# fiber_length_m: 3.0
# uart: 8N1 rtscts=False
# payload: 16 byte | pattern=incrementing | seq=True
# iterations: 1000
# warmup: 10
# interval_ms: 10.0
# timeout_ms: 1000.0
# read_mode: poll
# baudrates: 1340000
# note:
channel | baudrate | seq | t_send_ns | first_byte_us | latency_us | rx_len | err_bytes | stale_bytes | status
1 | 1340000 | 0 | 43669528238600 | 1489.300 | 1489.300 | 16 | 0 | 0 | OK
1 | 1340000 | 1 | 43669539831900 | 1446.600 | 1446.600 | 16 | 0 | 0 | OK
1 | 1340000 | 2 | 43669551337100 | 1526.900 | 1549.400 | 16 | 0 | 0 | OK
1 | 1340000 | 3 | 43669562951700 | 1600.400 | 1600.400 | 16 | 0 | 0 | OK
1 | 1340000 | 4 | 43669574604700 | 1496.400 | 1496.400 | 16 | 0 | 0 | OK
1 | 1340000 | 5 | 43669586156700 | 1542.600 | 1562.200 | 16 | 0 | 0 | OK
1 | 1340000 | 6 | 43669597747000 | 1637.800 | 1686.600 | 16 | 0 | 0 | OK
1 | 1340000 | 7 | 43669609477900 | 1452.900 | 1452.900 | 16 | 0 | 0 | OK
1 | 1340000 | 8 | 43669620969500 | 1567.800 | 1567.800 | 16 | 0 | 0 | OK
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
