hanskimvz/ELOP/TestProgram/results/latency_B_ch1_20261005_140714.xlsx

Sheet: Summary
Metadata
program_version | 0.1.0
started | 2026-10-05T14:07:14
pc | HPC
port | COM4
adapter | CH340 (USB-SERIAL CH340(COM4))
setup | B - 로컬 RS-422 루프백 (로컬 MAX3490)
channel_no | 1
fiber_length_m | 3.0
uart | 8N1 rtscts=False
payload | 16 byte, pattern=incrementing, seq=True
iterations | 1000
warmup | 10
interval_ms | 10.0
timeout_ms | 1000.0
read_mode | poll
baudrates | 1340000
note
Statistics (OK records only)
item | unit | 1340000
baudrate | bps | 1340000
count |  | 1000
ok |  | 1000
timeout |  | 0
mismatch |  | 0
seq_error |  | 0
err_bytes | byte | 0
byte_error_rate |  | 0
stale_bytes | byte | 0
min | us | 1439.7
max | us | 2299.7
mean | us | 1573.9833
stdev | us | 98.7501505
SE | us | 3.122753949
p50 | us | 1544.7
p95 | us | 1716.245
p99 | us | 2000.332
first_byte_mean | us | 1566.0222
T_wire (theory) | us | 119.4029851
fiber RTT (theory) | us | 0
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
