hanskimvz/ELOP/TestProgram/results/latency_B_ch1_20261005_140728.csv

# program_version: 0.1.0
# started: 2026-10-05T14:07:28
# pc: HPC
# port: COM4
# adapter: CH340 (USB-SERIAL CH340(COM4))
# setup: B - 로컬 RS-422 루프백 (로컬 MAX3490)
# channel_no: 1
# fiber_length_m: 3.0
# uart: 8N1 rtscts=False
# payload: 16 byte | pattern=incrementing | seq=True
# iterations: 1000
# warmup: 10
# interval_ms: 10.0
# timeout_ms: 1000.0
# read_mode: poll
# baudrates: 1340000
# note:
channel | baudrate | seq | t_send_ns | first_byte_us | latency_us | rx_len | err_bytes | stale_bytes | status
1 | 1340000 | 0 | 43683562364800 | 1486.600 | 1521.400 | 16 | 0 | 0 | OK
1 | 1340000 | 1 | 43683573960500 | 1623.900 | 1641.600 | 16 | 0 | 0 | OK
1 | 1340000 | 2 | 43683585633400 | 1507.700 | 1507.700 | 16 | 0 | 0 | OK
1 | 1340000 | 3 | 43683597175300 | 1557.700 | 1557.700 | 16 | 0 | 0 | OK
1 | 1340000 | 4 | 43683608765700 | 1486.000 | 1500.300 | 16 | 0 | 0 | OK
1 | 1340000 | 5 | 43683620291900 | 1547.800 | 1547.800 | 16 | 0 | 0 | OK
1 | 1340000 | 6 | 43683631864600 | 1660.200 | 1660.200 | 16 | 0 | 0 | OK
1 | 1340000 | 7 | 43683643604100 | 1500.800 | 1526.000 | 16 | 0 | 0 | OK
1 | 1340000 | 8 | 43683655190500 | 1469.400 | 1469.400 | 16 | 0 | 0 | OK
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
