hanskimvz/ELOP/TestProgram/results/latency_B_ch1_20261005_140743.csv

# program_version: 0.1.0
# started: 2026-10-05T14:07:43
# pc: HPC
# port: COM4
# adapter: CH340 (USB-SERIAL CH340(COM4))
# setup: B - 로컬 RS-422 루프백 (로컬 MAX3490)
# channel_no: 1
# fiber_length_m: 3.0
# uart: 8N1 rtscts=False
# payload: 16 byte | pattern=incrementing | seq=True
# iterations: 1000
# warmup: 10
# interval_ms: 10.0
# timeout_ms: 1000.0
# read_mode: poll
# baudrates: 1340000
# note:
channel | baudrate | seq | t_send_ns | first_byte_us | latency_us | rx_len | err_bytes | stale_bytes | status
1 | 1340000 | 0 | 43699019275700 | 1613.900 | 1649.900 | 16 | 0 | 0 | OK
1 | 1340000 | 1 | 43699031008300 | 1545.800 | 1545.800 | 16 | 0 | 0 | OK
1 | 1340000 | 2 | 43699042589800 | 1581.300 | 1581.300 | 16 | 0 | 0 | OK
1 | 1340000 | 3 | 43699054207100 | 1656.400 | 1670.400 | 16 | 0 | 0 | OK
1 | 1340000 | 4 | 43699065906500 | 1579.400 | 1579.400 | 16 | 0 | 0 | OK
1 | 1340000 | 5 | 43699077519400 | 1535.400 | 1573.600 | 16 | 0 | 0 | OK
1 | 1340000 | 6 | 43699089131300 | 1488.600 | 1488.600 | 16 | 0 | 0 | OK
1 | 1340000 | 7 | 43699100657100 | 1473.500 | 1488.200 | 16 | 0 | 0 | OK
1 | 1340000 | 8 | 43699112166700 | 1515.400 | 1515.400 | 16 | 0 | 0 | OK
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
