hanskimvz/ELOP/(list of files, drawings)

Other design files:
schematic/ELOP_V0.90.DSN
schematic/elop_v0.90.opj
schematic/ELOP_V0.90.pcbdoc
schematic/ELOP_V0.90.PrjPCB
